Quetalas/RoboPrint/Docs/Электроника/Шаговик.jpg

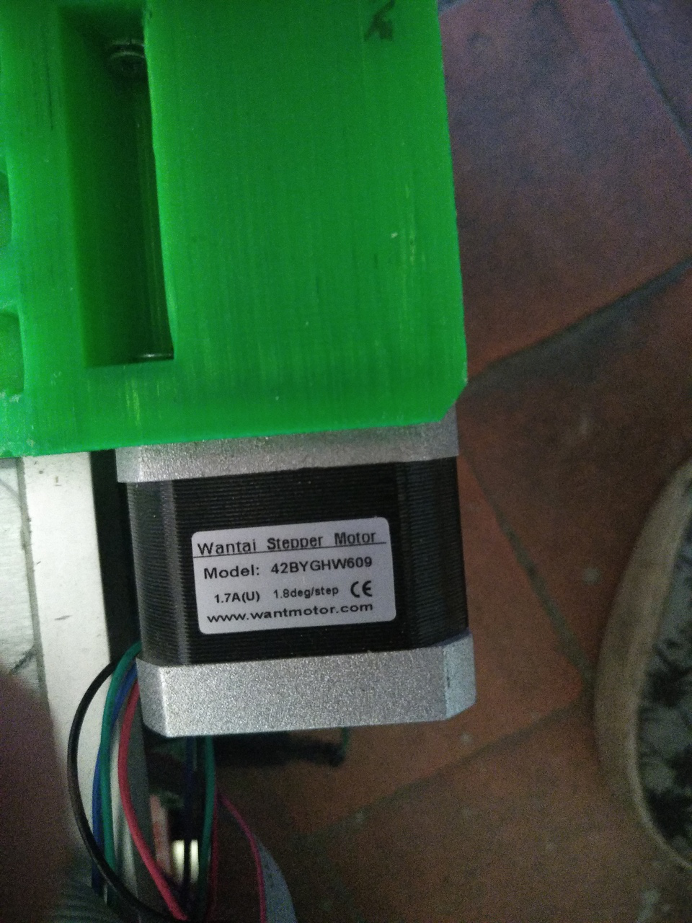
Docs/Электроника/Шаговик.jpg
