Quetalas/RoboPrint/Docs/Электроника/Драйвер шаговика.jpg

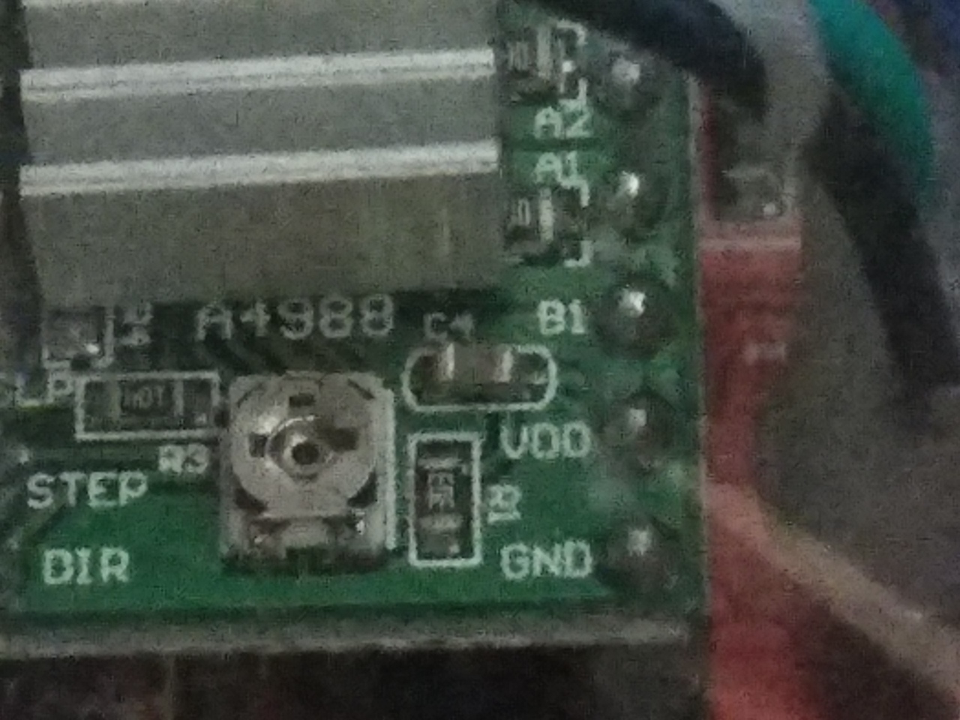
Docs/Электроника/Драйвер шаговика.jpg
