Quetalas/RoboPrint/Код/TestPrint.stl

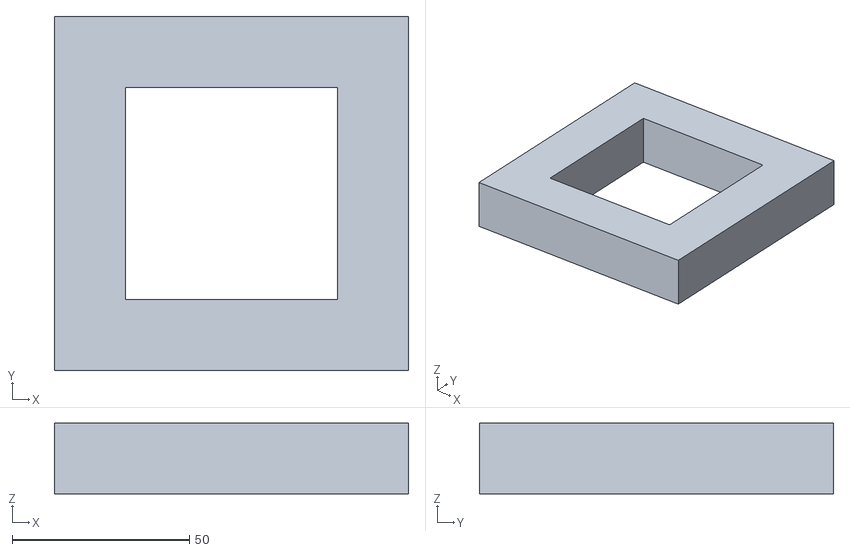
[picture p10: CAD file, 2019-07-14, last stored version]
Код/TestPrint.stl
100.0 x 100.0 x 20.0
