Quetalas/RoboPrint/(threads)

Thread 2 (2019-07-09):

Собрать печатный механизм

savalena, 2019-07-09:
- [x] нагреватель
- [x] кулер для охлаждения радиатора
- [x] термопара
- [x] подложка на стол
- [x] переходник для трубочки
- [x] драйвер для двигателя экструдера
- [x] провода
- [x] инструменты
- [x] собрать всю электронику
- [x]  разобраться с переходником и труьбочкой

Closed 2019-07-17.

Thread 7 (2019-08-05):

Калибровка по столу

savalena, 2019-08-05:
- [ ] выровнять стол
- [ ] купить, подключить, откалибровать дальномер
- [ ] код, получающий 3 точки стола
- [ ] код, переводящий по 3ём точкам координаты модели в координаты неидеального стола
- [ ] модификация движения, чтобы можно было двигаться в пространестве
