Quetalas/RoboPrint/(commit log)

2019-06-25 Add all our material
    собрал в одном месте и рассортировал весь имеющийся материал
2019-06-25 add photos of motor and driver
2019-06-27 Create kinematics_with_SD
2019-07-08 Add Kinematics DOC`s / Delete old files
2019-07-14 Add model for print
    [TestPrint.stl]
2019-08-11 add all except arduino move_to
2019-08-18 add heating tower moving
2019-08-18 review of temperature control
2019-11-11 replace by new tower code
    [connection.cpp, connection.h, moving_stepper.cpp, moving_stepper.h, temperature.cpp, temperature.h, touch_sensor.cpp, touch_sensor.h]
2019-11-11 replace server files by new files
    [calibration_table.py, connections.py, edge_search.py, filter_sorted.py, heater.py, main.py, printer.py]
